cracked-machine/TremoloPedals/README.md

# TremoloPedals

[Atomizer Tremolo](Atomizer/atomizer.md)
