cracked-machine/TremoloPedals/docs/README.md

# TremoloPedals

### Atomizer Tremolo Pedal

Digitally-controlled, analog optical tremolo pedal.

| Features | Power Requirements | Audio clip |
|---|---|:---:|
|<ul><li>Adjustable mix and output gain</li><li>Lowest clock speed 2Hz</li><li>Square and Triangle waveform</li><li>Normal, Skew and Sweep modes</li><li>True bypass</li></ul>|<ul><li>9VDC</li><li>center negative</li><li>30mA</li></ul>|Watch the demo (https://www.instagram.com/p/BsmGDgeASrn/)|

<a href="atomizer_ibom.html">Interactive BOM</a>
