cracked-machine/TremoloPedals/Atomizer/atomizer.md

### Atomizer Tremolo Pedal

Digitally-controlled, analog optical tremolo pedal.

| Features | Power Requirements | Audio clip |
|---|---|:---:|
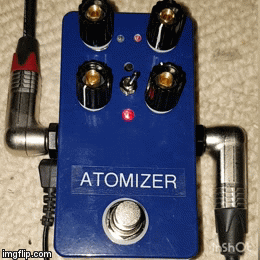
[picture p1: Atomizer/docs/Atomizer.gif]
Watch the demo (https://www.instagram.com/p/BsmGDgeASrn/)
|<ul><li>Adjustable mix and output gain</li><li>Lowest clock speed 2Hz</li><li>Square and Triangle waveform</li><li>Normal, Skew and Sweep modes</li><li>True bypass</li></ul>|<ul><li>9VDC</li><li>center negative</li><li>30mA</li></ul>||

<a href="https://cracked-machine.github.io/TremoloPedals/Atomizer/docs/IBOM/ibom.html">Interactive BOM</a>
