cracked-machine/TremoloPedals/Atomizer/docs/AtomizerRevA_BoardBottomCopper.png

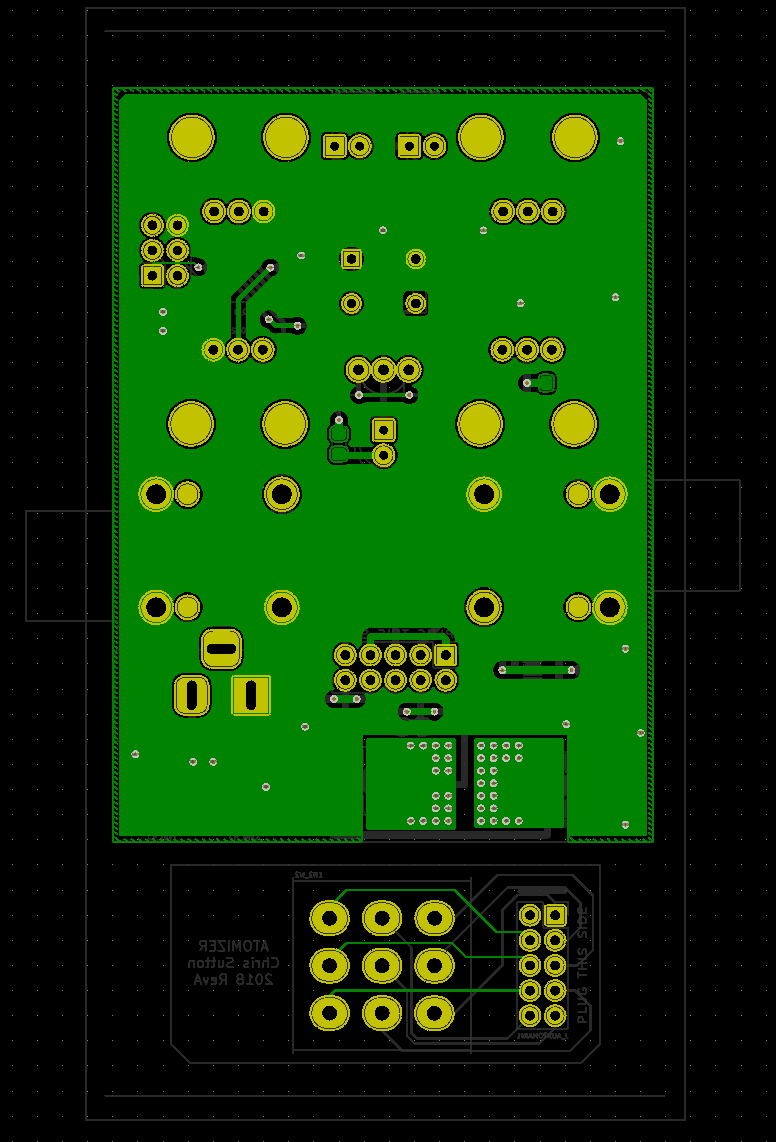
Atomizer/docs/AtomizerRevA_BoardBottomCopper.png
