cracked-machine/TremoloPedals/Atomizer/docs/AtomizerRevA_BoardTopCopper.png

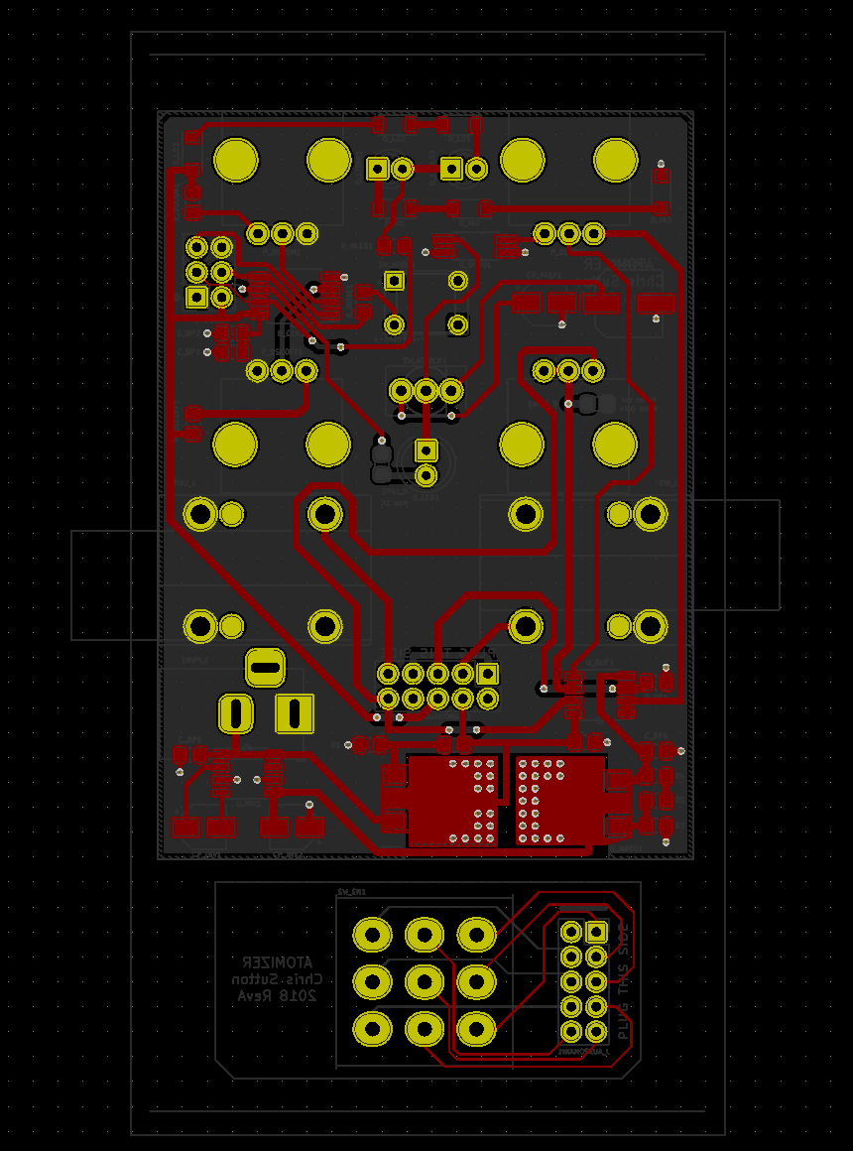
Atomizer/docs/AtomizerRevA_BoardTopCopper.png
