cracked-machine/TremoloPedals/Atomizer/docs/BoardLayout_3DRenderings/Populated.png

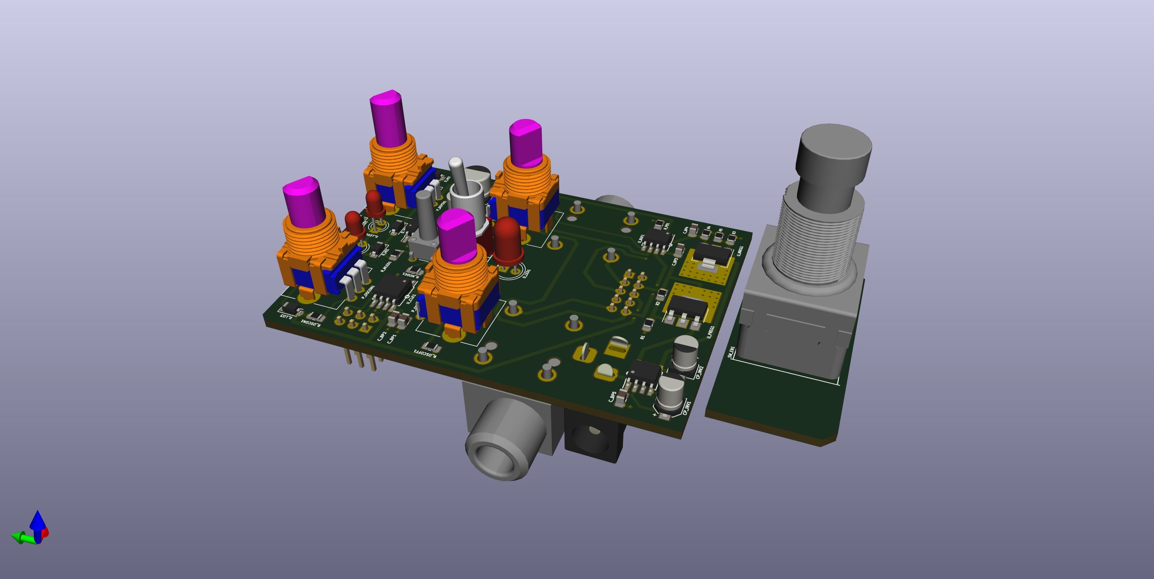
Atomizer/docs/BoardLayout_3DRenderings/Populated.png
