cracked-machine/TremoloPedals/Atomizer/docs/BoardLayout_3DRenderings/Unpopulated.png

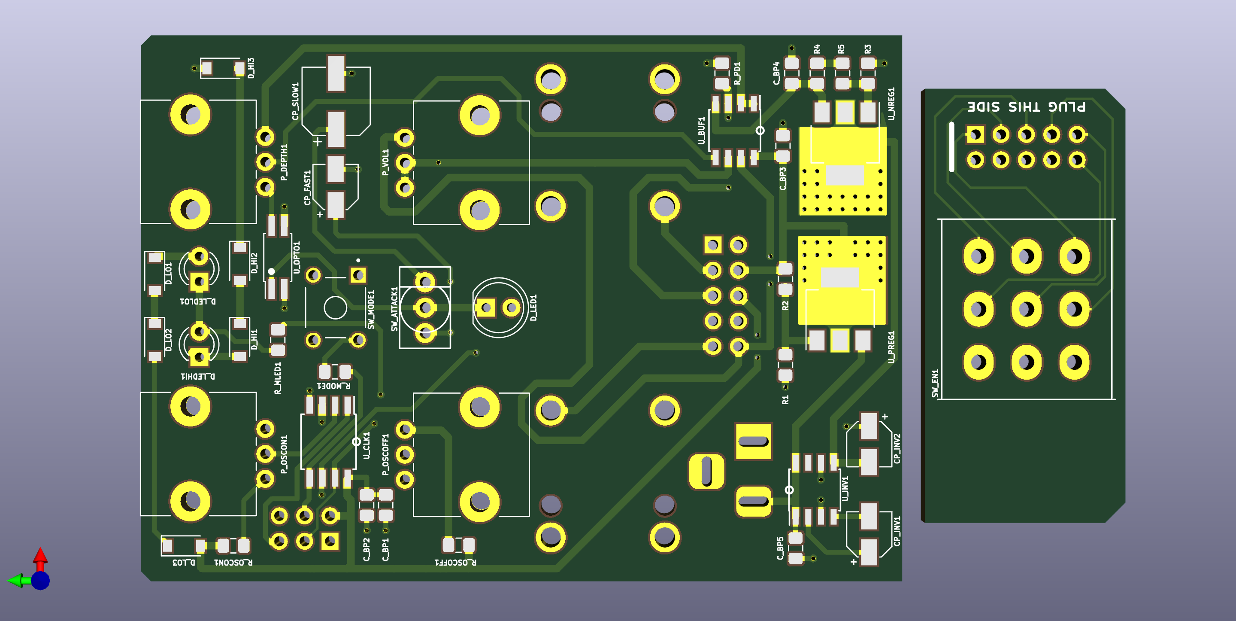
Atomizer/docs/BoardLayout_3DRenderings/Unpopulated.png
