cracked-machine/TremoloPedals/Atomizer/docs/Bypass/bp_47u.png

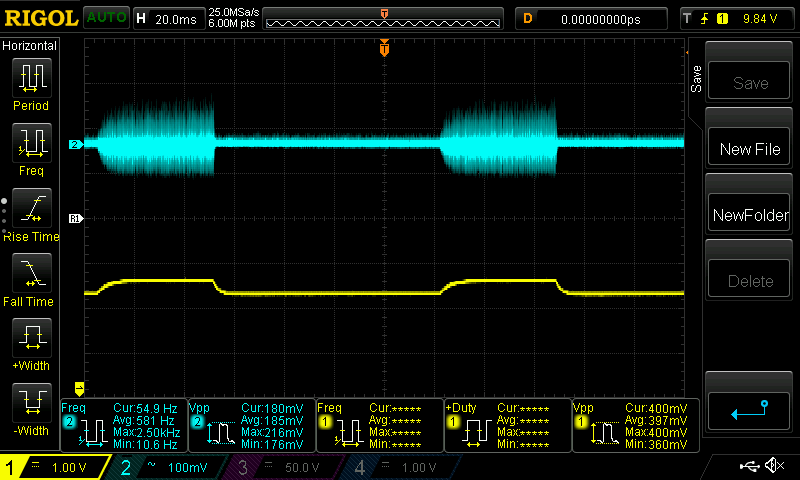
Atomizer/docs/Bypass/bp_47u.png
