cracked-machine/TremoloPedals/Atomizer/docs/Bypass/bp_100n.png

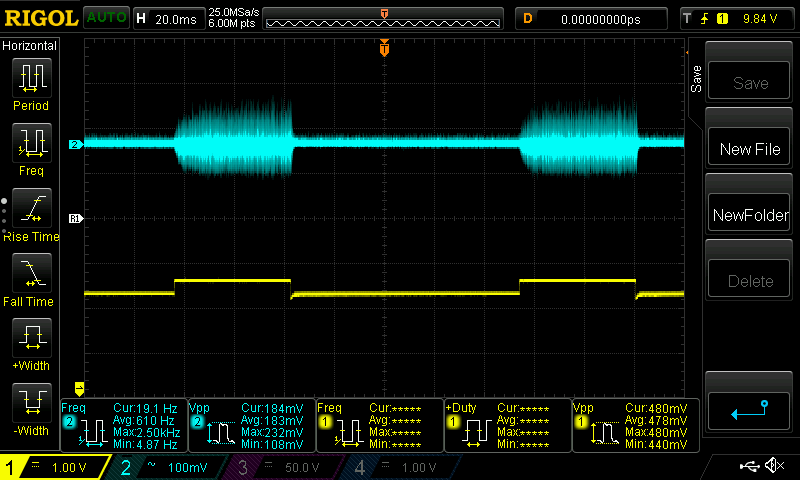
Atomizer/docs/Bypass/bp_100n.png
