cracked-machine/TremoloPedals/HexTremolo/docs/3D1.png

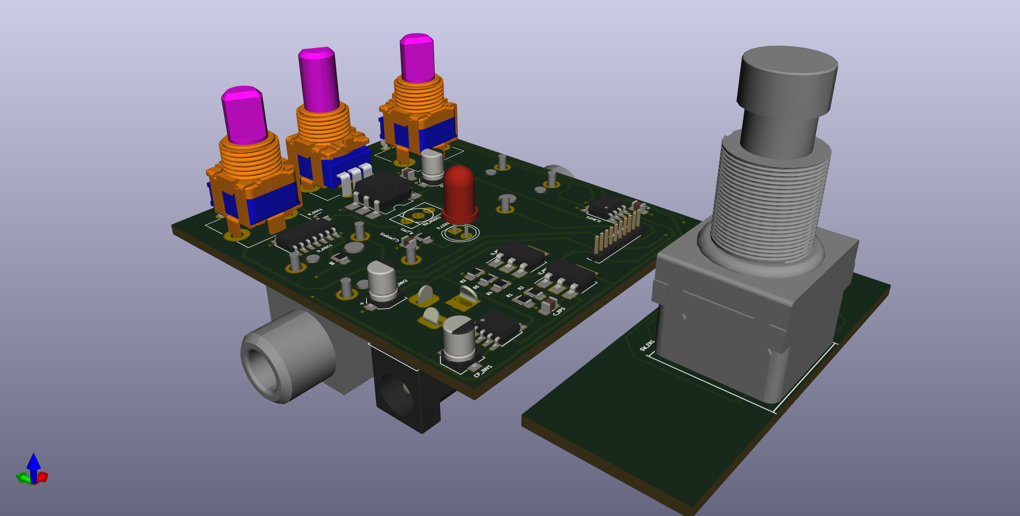
HexTremolo/docs/3D1.png
