cracked-machine/TremoloPedals/HexTremolo/docs/3D2.png

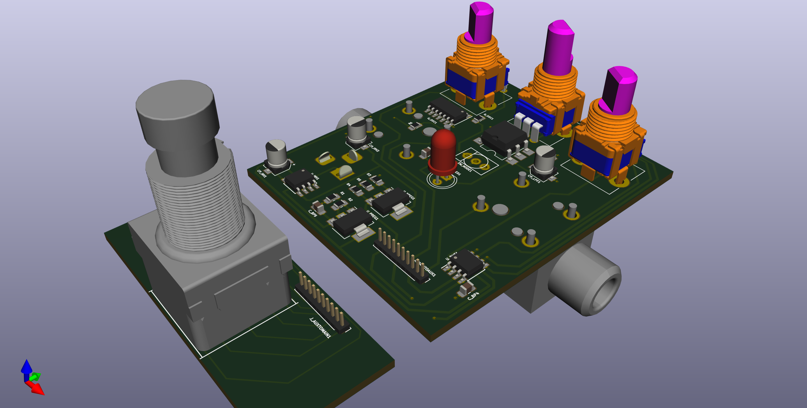
HexTremolo/docs/3D2.png
