cracked-machine/TremoloPedals/HexTremolo/docs/3D3.png

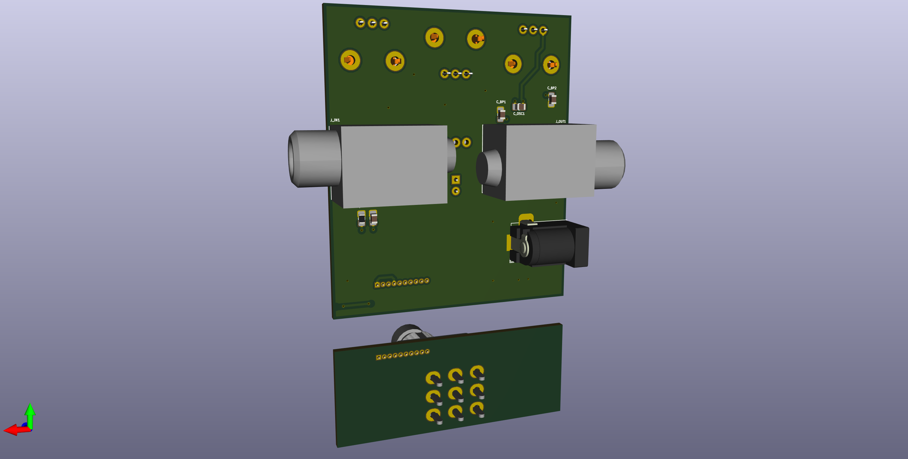
HexTremolo/docs/3D3.png
