cracked-machine/TremoloPedals/Atomizer/docs/SchematicFIles/Atomizer.pdf

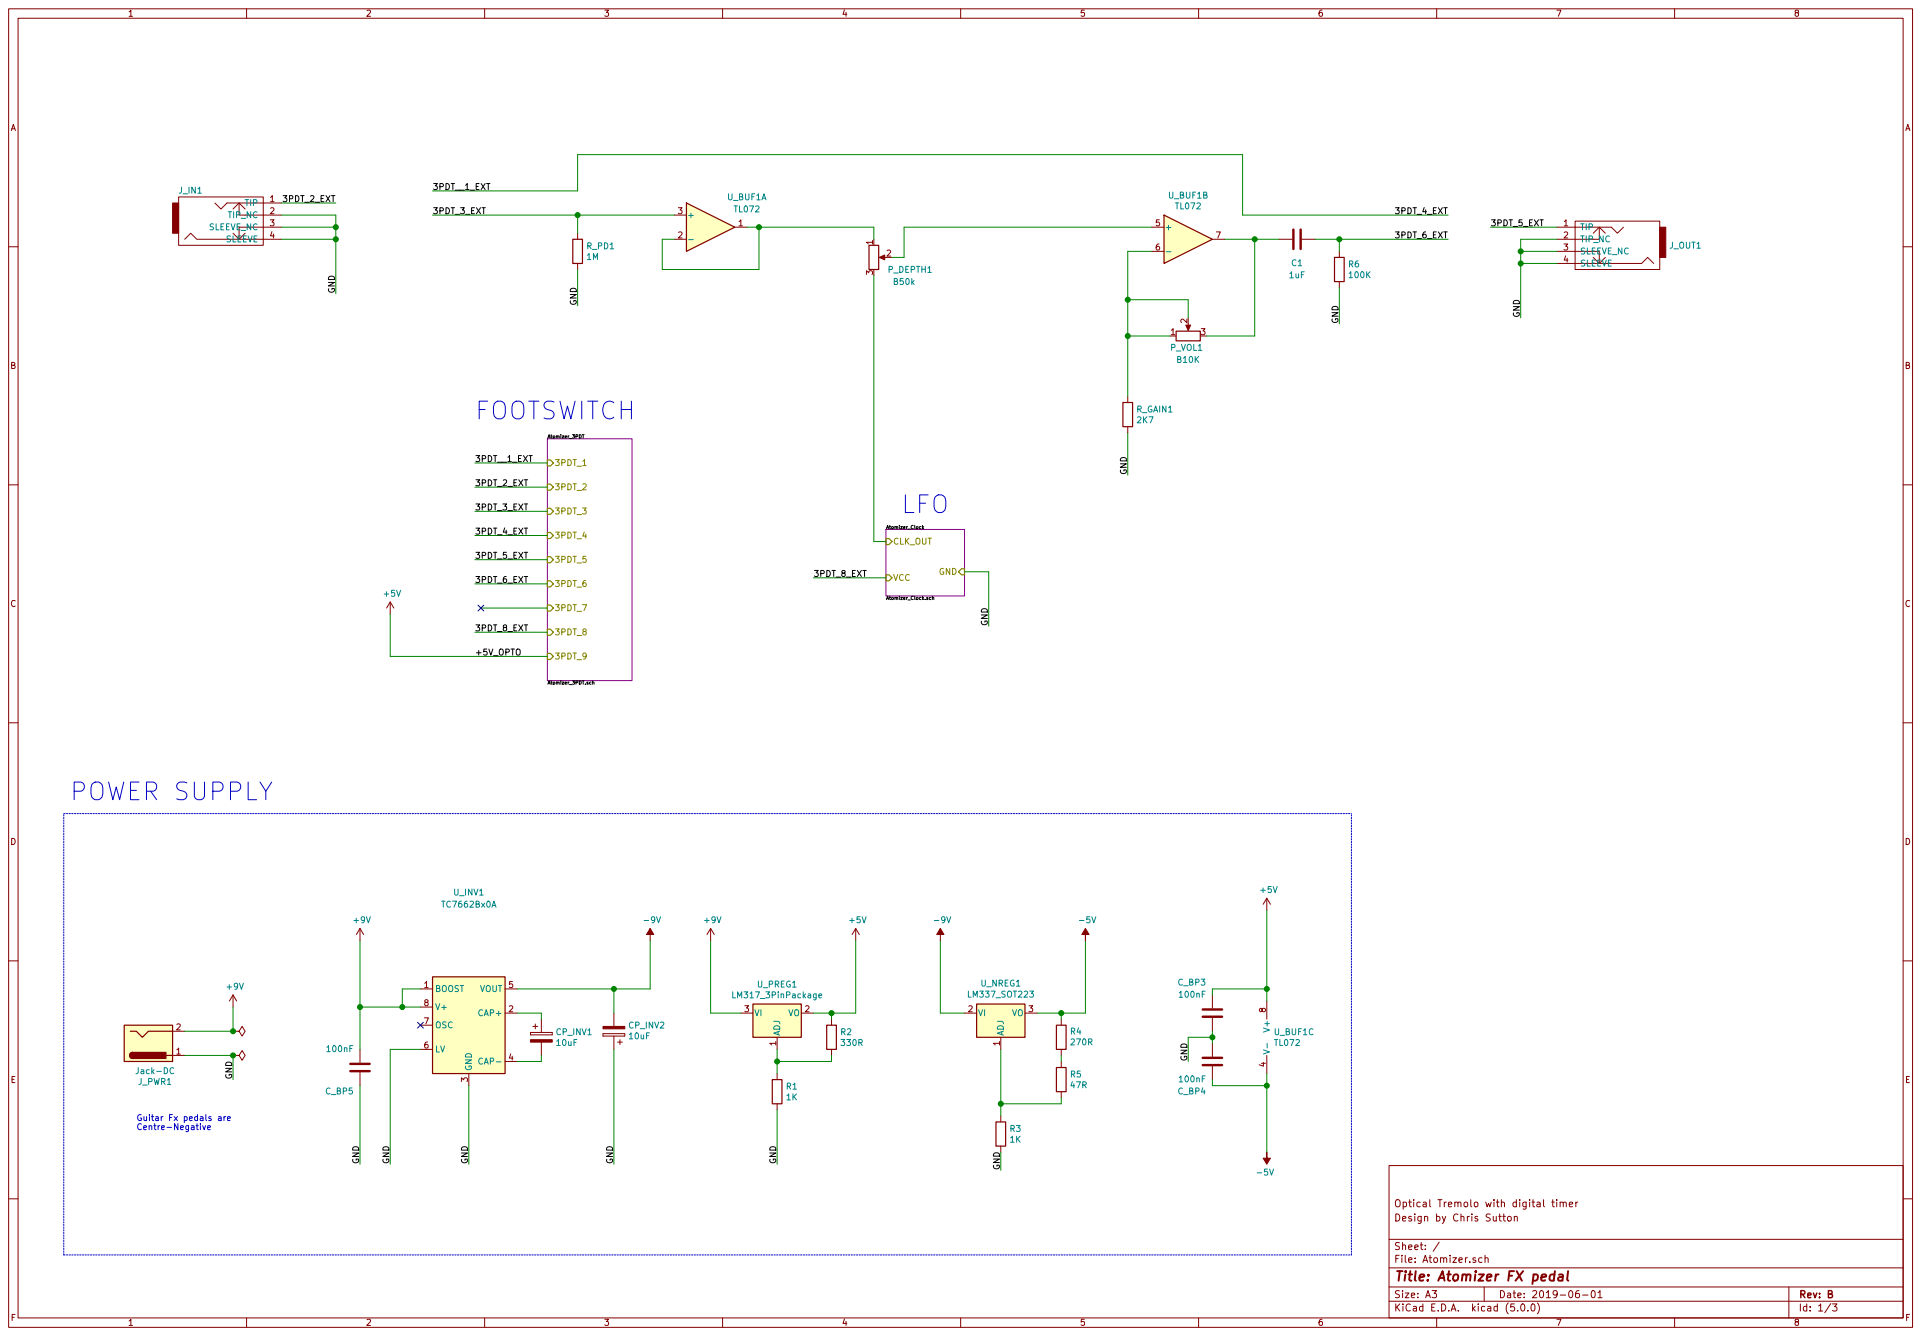
[picture p13: page 1]

Guitar Fx pedals are
Centre-Negative

Id: 1/3 Title: Atomizer FX pedal File: Atomizer.sch Sheet: / Design by Chris Sutton

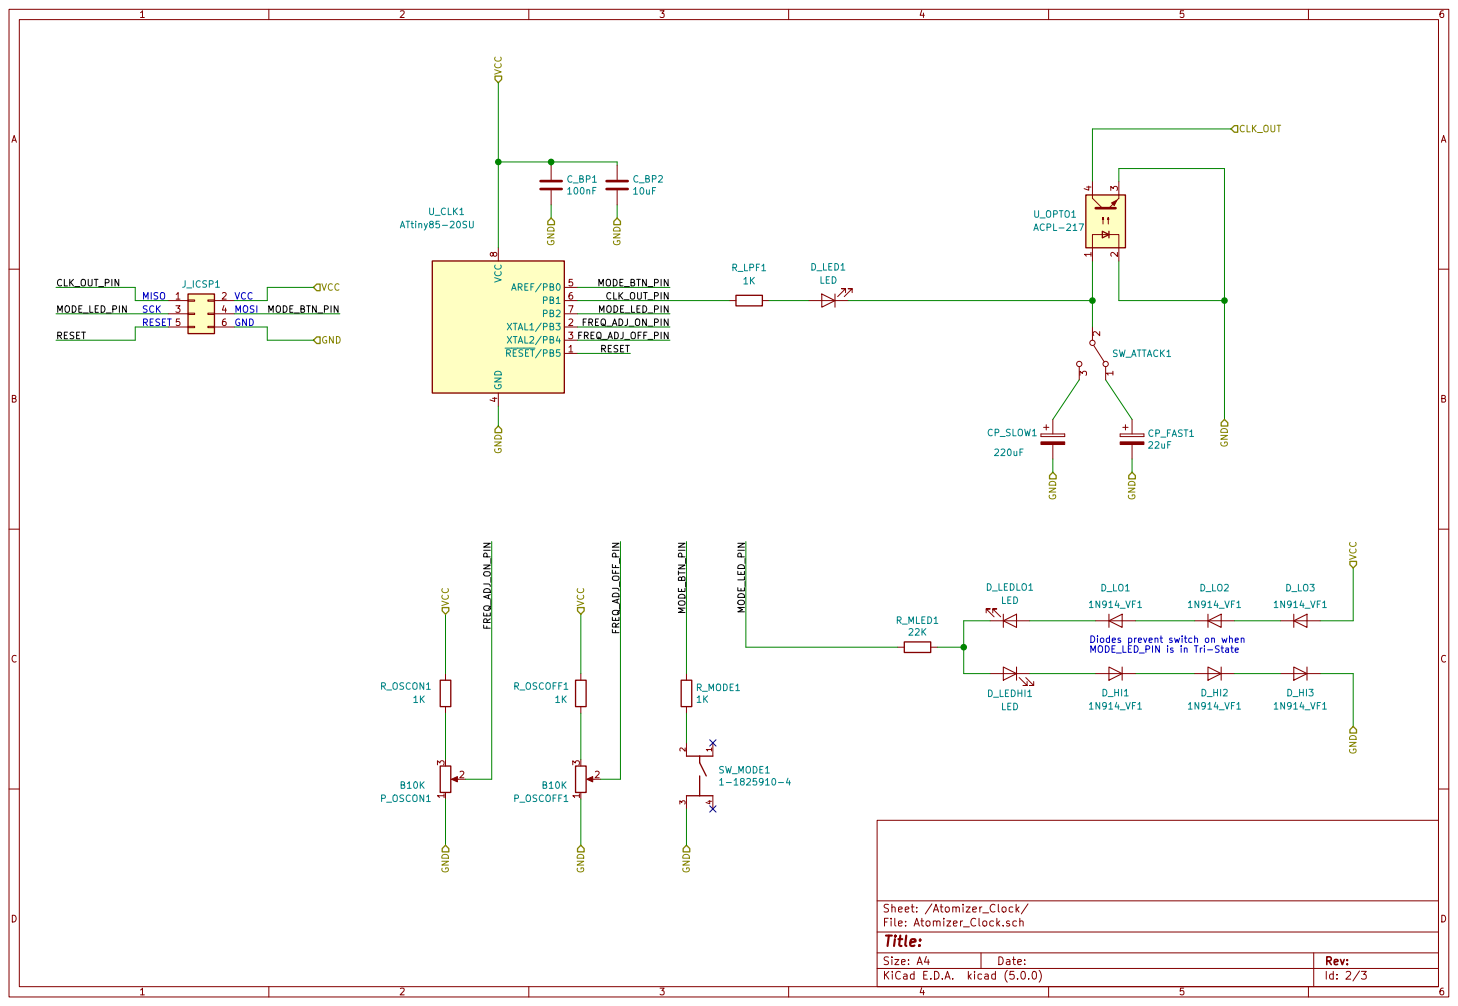
[picture p14: page 2]

Diodes prevent switch on when MODE_LED_PIN is in Tri-State D_LO2

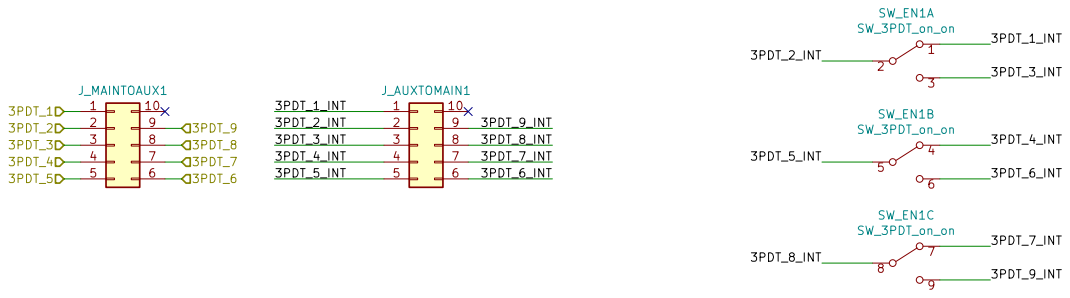
[picture p15: page 3]
