cracked-machine/TremoloPedals/HexTremolo/docs/HexTremolo.pdf

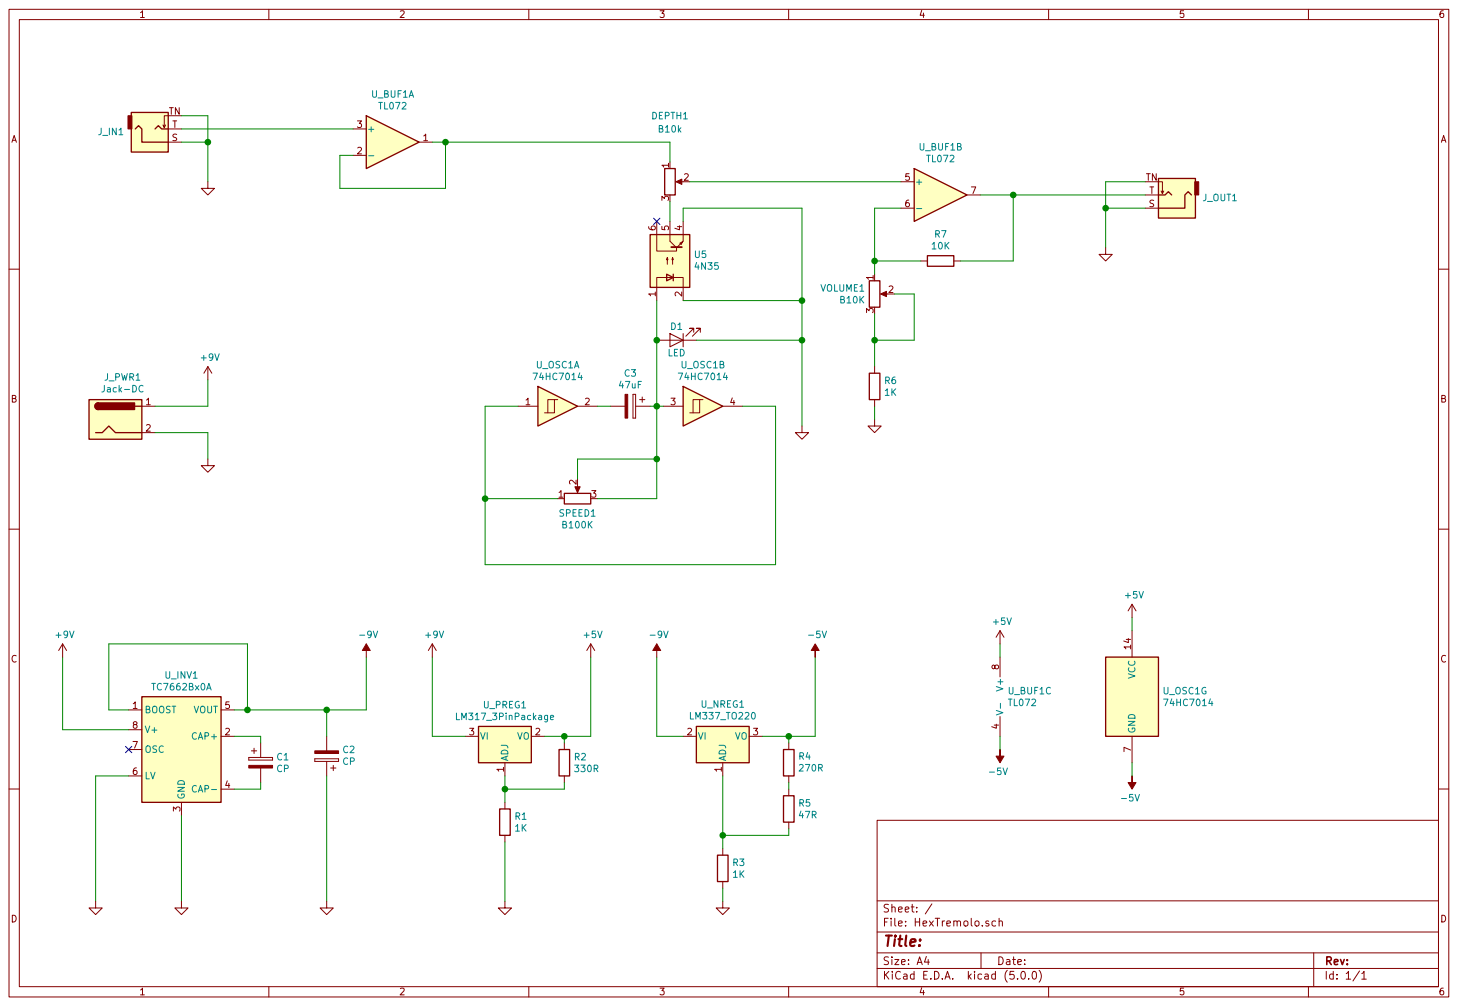
[picture p16: page 1]
