cracked-machine/TremoloPedals/Atomizer/hardware/Atomizer.kicad_pcb

## KiCad design Atomizer/hardware/Atomizer.kicad_pcb (2019-06-01)

Schematic: Atomizer.sch, Atomizer FX pedal

Parts:
C1: 1uF; C_0805_2012Metric_Pad1.15x1.40mm_HandSolder
CP_INV1, CP_INV2: 10uF; CP_Elec_4x5.4; MouserNo 140-VE100M1CTR0405
C_BP3, C_BP4, C_BP5: 100nF; C_0805_2012Metric_Pad1.15x1.40mm_HandSolder; MouserNo 710-885012207098
J_IN1: JACK__MONO_2P_NC; 6_35MM_JACK_MONO_FlatTop_notab; MouserNo 550-10284G
J_OUT1: JACK__MONO_2P_NC; 6_35MM_JACK_MONO_FlatTop_notab; MouserNo 550-10284G
J_PWR1: Jack-DC; BarrelJack_Horizontal; MouserNo 502-RAPC722X
P_DEPTH1: B50k; Potentiometer_Alps_RK09L_Single_Vertical; MouserNo 688-RK09L1140A5P
P_VOL1: B10K; Potentiometer_Alps_RK09L_Single_Vertical; MouserNo 688-RK09L1140A66
R1, R3: 1K; R_0805_2012Metric_Pad1.15x1.40mm_HandSolder; MouserNo 279-CRGP0805F1K0
R2: 330R; R_0805_2012Metric_Pad1.15x1.40mm_HandSolder; MouserNo 71-CRCW0805330RFKEAC
R4: 270R; R_0805_2012Metric_Pad1.15x1.40mm_HandSolder; MouserNo 667-ERJ-6ENF2700V
R5: 47R; R_0805_2012Metric_Pad1.15x1.40mm_HandSolder; MouserNo 667-ERJ-6ENF47R0V
R6: 100K; R_0805_2012Metric_Pad1.15x1.40mm_HandSolder
R_GAIN1: 2K7; R_0805_2012Metric_Pad1.15x1.40mm_HandSolder; MouserNo 279-CRGCQ0805F2K7
R_PD1: 1M; R_0805_2012Metric_Pad1.15x1.40mm_HandSolder; MouserNo 755-UCR10EVHFSR022
U_BUF1: TL072; SOIC-8_3.9x4.9mm_P1.27mm; MouserNo 621-TL072SG-13
U_INV1: TC7662Bx0A; SOIC-8_3.9x4.9mm_P1.27mm; MouserNo 579-TC7660SEOA713
U_NREG1: LM337_SOT223; SOT-223-3_TabPin2; MouserNo 926-LM337IMP/NOPB
U_PREG1: LM317_3PinPackage; SOT-223-3_TabPin2; MouserNo 595-LM317DCYR

Connections:
+5V: C_BP3.2, R2.1, U_BUF1.8 (V+), U_PREG1.2; also elsewhere on the board
+9V: C_BP5.2, J_PWR1.2, U_INV1.1, U_INV1.8, U_PREG1.3
-5V: C_BP4.1, R4.2, U_BUF1.4 (V-), U_NREG1.3
-9V: CP_INV2.2, U_INV1.5, U_NREG1.2
/3PDT_2_EXT: J_IN1.1; also elsewhere on the board
/3PDT_3_EXT: R_PD1.1, U_BUF1.3 (+); also elsewhere on the board
/3PDT_5_EXT: J_OUT1.1; also elsewhere on the board
/3PDT_6_EXT: C1.1, R6.1; also elsewhere on the board
/Atomizer_Clock/CLK_OUT: P_DEPTH1.3; also elsewhere on the board
/GND: CP_INV2.1, C_BP3.1, C_BP4.2, C_BP5.1, J_IN1.2, J_IN1.3, J_IN1.4, J_OUT1.2, J_OUT1.3, J_OUT1.4, J_PWR1.1, R1.2, R3.2, R6.2, R_GAIN1.2, R_PD1.2, U_INV1.3, U_INV1.6; also elsewhere on the board
unnamed: C1.2, P_VOL1.3, U_BUF1.7
unnamed: CP_INV1.1, U_INV1.2
unnamed: CP_INV1.2, U_INV1.4
unnamed: P_DEPTH1.1, U_BUF1.1, U_BUF1.2 (-)
unnamed: P_DEPTH1.2, U_BUF1.5 (+)
unnamed: P_VOL1.1, P_VOL1.2, R_GAIN1.1, U_BUF1.6 (-)
unnamed: R1.1, R2.2, U_PREG1.1
unnamed: R3.1, R5.2, U_NREG1.1
unnamed: R4.1, R5.1

Notes on the sheet:
POWER SUPPLY
FOOTSWITCH
LFO
Guitar Fx pedals are Centre-Negative

Schematic: Atomizer_Clock.sch

Parts:
CP_FAST1: 22uF; CP_Elec_4x5.4; Tolerance 20%; Voltage Rating DC 10 DC; MouserNo 710-875105240003
CP_SLOW1: 220uF; CP_Elec_6.3x5.4; Voltage Rating DC 16 VDC; Tolerance 20 %; MouserNo 667-EEE-FPC221XAP
C_BP1: 100nF; C_0805_2012Metric_Pad1.15x1.40mm_HandSolder; MouserNo 710-885012207098
C_BP2: 10uF; C_0805_2012Metric_Pad1.15x1.40mm_HandSolder; MouserNo 81-GRM21BC81C106KE5K
D_HI1, D_HI2, D_HI3: 1N914_VF1; D_SOD-123; MouserNo 821-1N914BWRH
D_LED1: LED; LED_D5.0mm; MouserNo 859-LTL-307EE
D_LEDHI1: LED; LED_D3.0mm; MouserNo 941-C4SMABGFCR2T3451
D_LEDLO1: LED; LED_D3.0mm; MouserNo 941-C4SMABGFCR2T3451
D_LO1, D_LO2, D_LO3: 1N914_VF1; D_SOD-123; MouserNo 821-1N914BWRH
J_ICSP1: Conn_02x03_Odd_Even; PinHeader_2x03_P2.54mm_Vertical; MouserNo 538-22-28-4062
P_OSCOFF1: B10K; Potentiometer_Alps_RK09L_Single_Vertical; MouserNo 688-RK09L1140A66
P_OSCON1: B10K; Potentiometer_Alps_RK09L_Single_Vertical; MouserNo 688-RK09L1140A66
R_LPF1: 1K; R_0805_2012Metric_Pad1.15x1.40mm_HandSolder; MouserNo 279-CRGP0805F1K0
R_MLED1: 22K; R_0805_2012Metric_Pad1.15x1.40mm_HandSolder; MouserNo 667-ERJ-6ENF2202V
R_MODE1: 1K; R_0805_2012Metric_Pad1.15x1.40mm_HandSolder; MouserNo 279-CRGP0805F1K0
R_OSCOFF1: 1K; R_0805_2012Metric_Pad1.15x1.40mm_HandSolder; MouserNo 279-CRGP0805F1K0
R_OSCON1: 1K; R_0805_2012Metric_Pad1.15x1.40mm_HandSolder; MouserNo 279-CRGP0805F1K0
SW_ATTACK1: SW_SPDT; Dailywell_SPDT; MouserNo 108-2MS1T1B1M2QE-EVX
SW_MODE1: 1-1825910-4; SW_2-1825910-7; MouserNo 506-1-1825910-4
U_CLK1: ATtiny85-20SU; SOIJ-8_5.3x5.3mm_P1.27mm; MouserNo 556-ATTINY85-20SU
U_OPTO1: ACPL-217; SO-4_4.4x2.3mm_P1.27mm; MouserNo 630-ACPL-217-50BE

Connections:
/3PDT_8_EXT: C_BP1.1, C_BP2.1, D_LO3.2, J_ICSP1.2, R_OSCOFF1.2, R_OSCON1.2, U_CLK1.8 (VCC); also elsewhere on the board
/Atomizer_Clock/CLK_OUT: U_OPTO1.4; also elsewhere on the board
/Atomizer_Clock/CLK_OUT_PIN: J_ICSP1.1, R_LPF1.2, U_CLK1.6 (PB1)
/Atomizer_Clock/FREQ_ADJ_OFF_PIN: P_OSCOFF1.2, U_CLK1.3 (XTAL2/PB4)
/Atomizer_Clock/FREQ_ADJ_ON_PIN: P_OSCON1.2, U_CLK1.2 (XTAL1/PB3)
/Atomizer_Clock/MODE_BTN_PIN: J_ICSP1.4, R_MODE1.1, U_CLK1.5 (AREF/PB0)
/Atomizer_Clock/MODE_LED_PIN: J_ICSP1.3, R_MLED1.2, U_CLK1.7 (PB2)
/Atomizer_Clock/RESET: J_ICSP1.5, U_CLK1.1 (~RESET~/PB5)
/GND: CP_FAST1.2, CP_SLOW1.2, C_BP1.2, C_BP2.2, D_HI3.1, J_ICSP1.6, P_OSCOFF1.1, P_OSCON1.1, SW_MODE1.3, U_CLK1.4 (GND), U_OPTO1.2, U_OPTO1.3; also elsewhere on the board
unnamed: CP_FAST1.1, SW_ATTACK1.1
unnamed: CP_SLOW1.1, SW_ATTACK1.3
unnamed: D_HI1.1, D_HI2.2
unnamed: D_HI1.2, D_LEDHI1.1
unnamed: D_HI2.1, D_HI3.2
unnamed: D_LED1.1, SW_ATTACK1.2, U_OPTO1.1
unnamed: D_LED1.2, R_LPF1.1
unnamed: D_LEDHI1.2, D_LEDLO1.1, R_MLED1.1
unnamed: D_LEDLO1.2, D_LO1.1
unnamed: D_LO1.2, D_LO2.1
unnamed: D_LO2.2, D_LO3.1
unnamed: P_OSCOFF1.3, R_OSCOFF1.1
unnamed: P_OSCON1.3, R_OSCON1.1
unnamed: R_MODE1.2, SW_MODE1.2

Notes on the sheet:
Diodes prevent switch on when MODE_LED_PIN is in Tri-State
MOSI
VCC
GND
SCK
MISO
RESET

Schematic: Atomizer_3PDT.sch

Parts:
J_AUXTOMAIN1: Conn_02x05_Counter_Clockwise; IDCHeader_02x05_P2.54mm_Vertical_Counter_Clockwise; MouserNo 538-22-28-4102
J_MAINTOAUX1: Conn_02x05_Counter_Clockwise; IDCHeader_02x05_P2.54mm_Vertical_Clockwise; MouserNo 538-22-28-4102
SW_EN1: SW_3PDT_on_on; SW_3PDT_W18MM_L17.3MM_P5.3MM_D2MM; MouserNo 612-FS573PLT2B2M2QE

Connections:
+5V: J_MAINTOAUX1.9; also elsewhere on the board
/3PDT_2_EXT: J_MAINTOAUX1.2; also elsewhere on the board
/3PDT_3_EXT: J_MAINTOAUX1.3; also elsewhere on the board
/3PDT_4_EXT: J_MAINTOAUX1.1, J_MAINTOAUX1.4
/3PDT_5_EXT: J_MAINTOAUX1.5; also elsewhere on the board
/3PDT_6_EXT: J_MAINTOAUX1.6; also elsewhere on the board
/3PDT_8_EXT: J_MAINTOAUX1.8; also elsewhere on the board
/Atomizer_3PDT/3PDT_1_INT: J_AUXTOMAIN1.1, SW_EN1.1
/Atomizer_3PDT/3PDT_2_INT: J_AUXTOMAIN1.2, SW_EN1.2
/Atomizer_3PDT/3PDT_3_INT: J_AUXTOMAIN1.3, SW_EN1.3
/Atomizer_3PDT/3PDT_4_INT: J_AUXTOMAIN1.4, SW_EN1.4
/Atomizer_3PDT/3PDT_5_INT: J_AUXTOMAIN1.5, SW_EN1.5
/Atomizer_3PDT/3PDT_6_INT: J_AUXTOMAIN1.6, SW_EN1.6
/Atomizer_3PDT/3PDT_7_INT: J_AUXTOMAIN1.7, SW_EN1.7
/Atomizer_3PDT/3PDT_8_INT: J_AUXTOMAIN1.8, SW_EN1.8
/Atomizer_3PDT/3PDT_9_INT: J_AUXTOMAIN1.9, SW_EN1.9

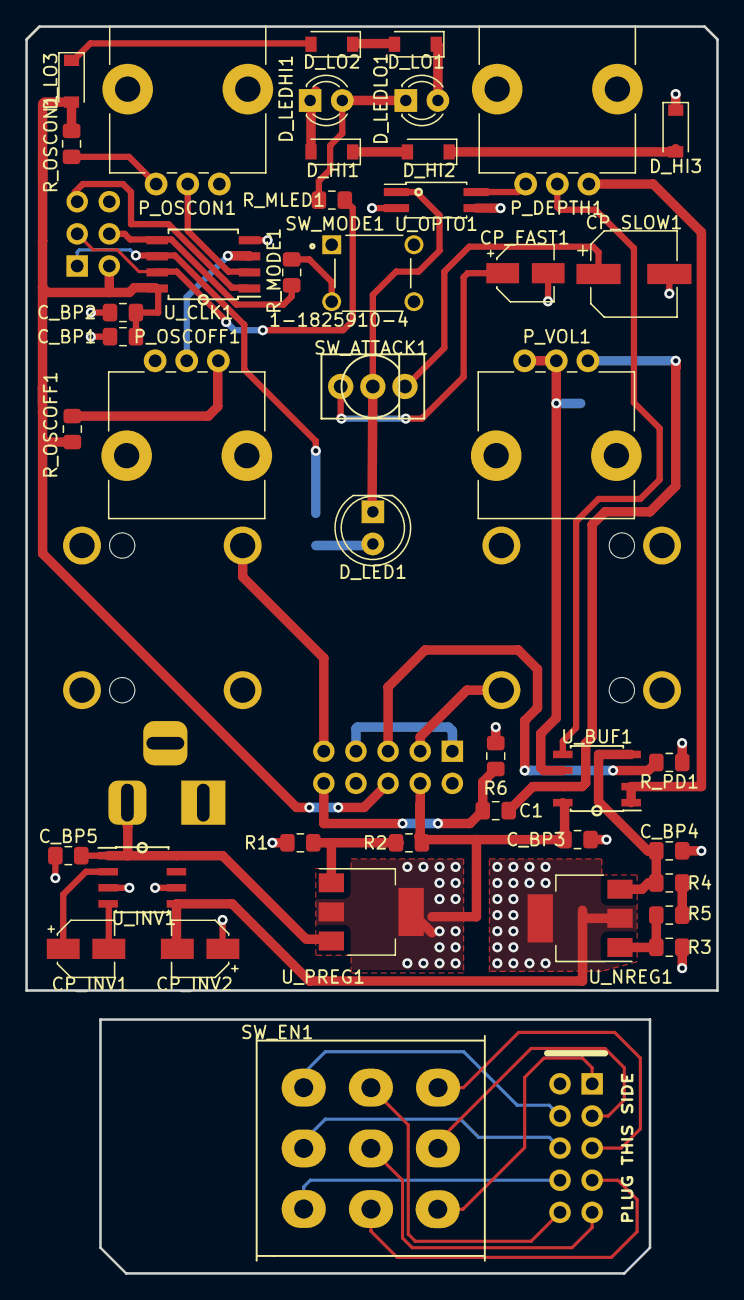
[picture p17: board Atomizer.kicad_pcb from above]

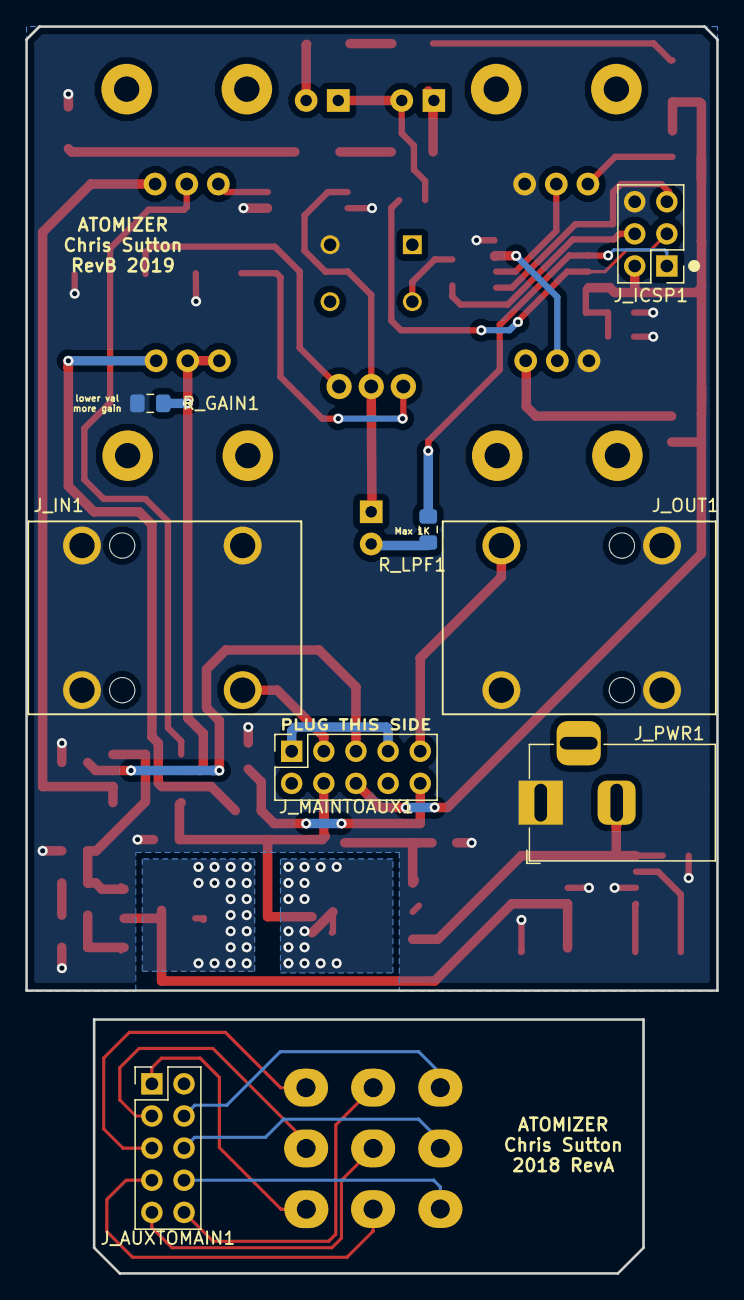
[picture p18: board Atomizer.kicad_pcb from below]

Board: 2 copper layers, 54.6 x 98.6 mm, 51 parts (8 on the bottom side), 50 nets.
