cracked-machine/TremoloPedals/EATremolo/EATremolo.kicad_pcb

## KiCad design EATremolo/EATremolo.kicad_pcb (2018-01-09)

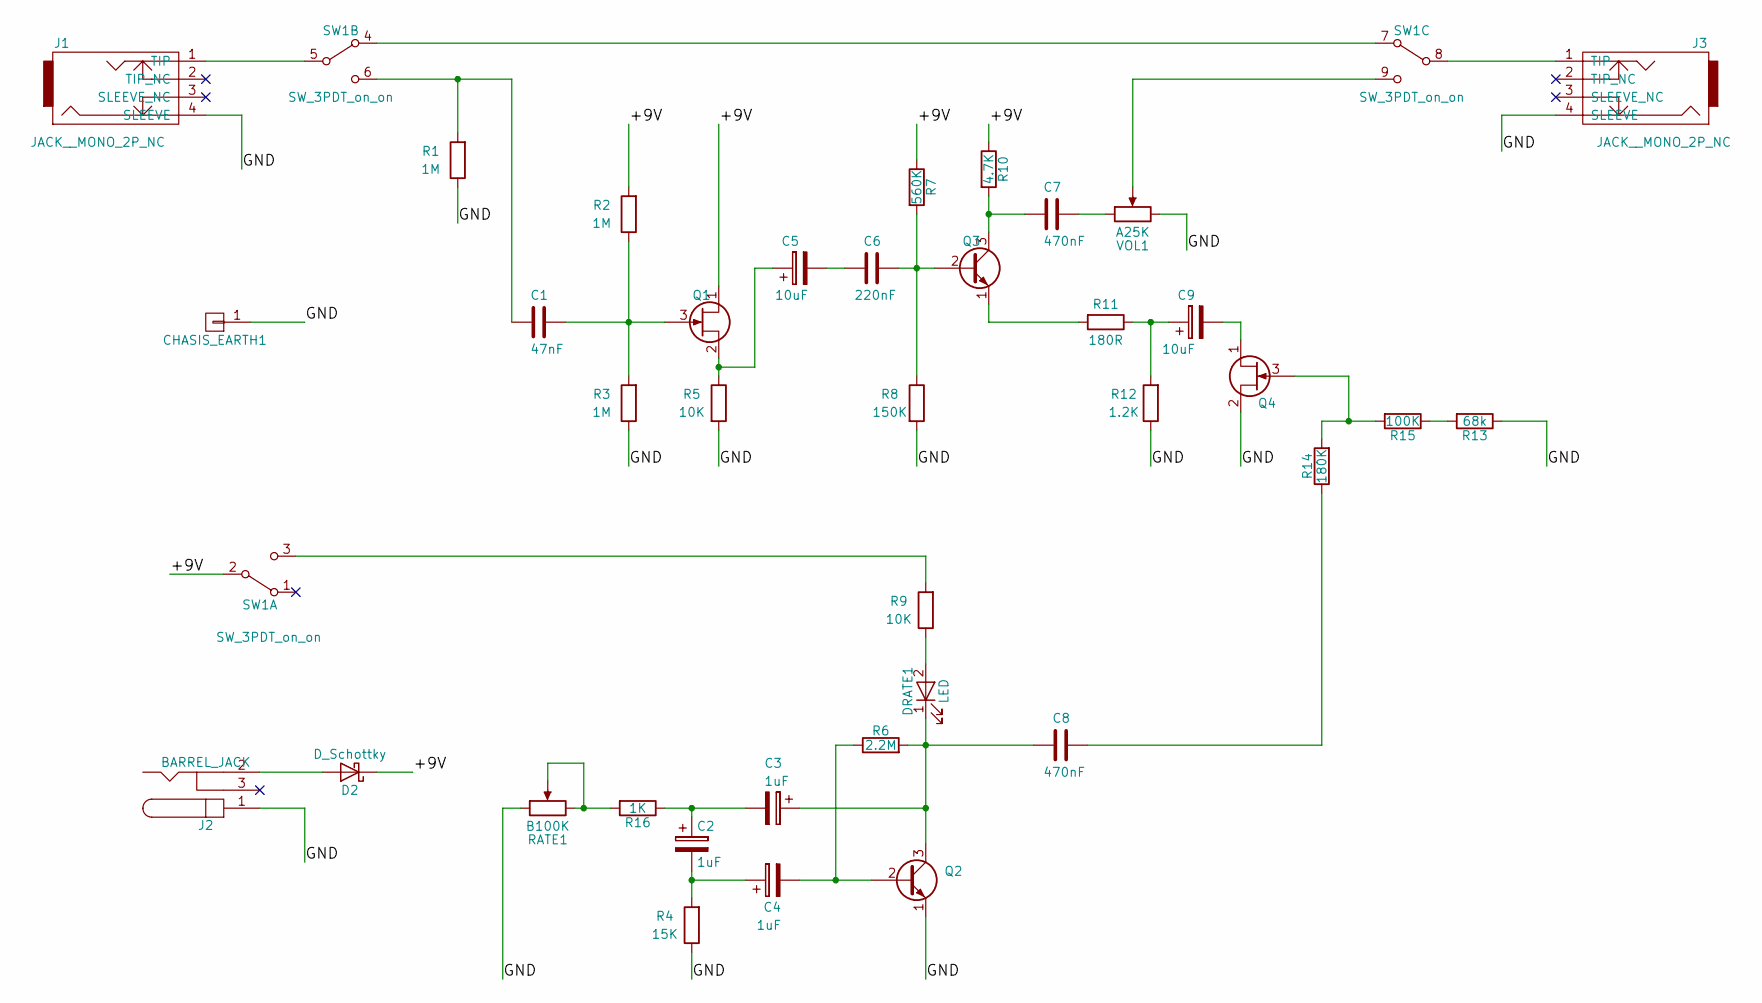
[picture p19: schematic EATremolo.sch]

Parts:
C1: 47nF; C_Disc_2mmPads
C2, C3, C4: 1uF; C_Disc_2mmPads
C5: 10uF; C_Disc_P5.0mm_2mmPads
C6: 220nF; C_Disc_2mmPads
C7: 470nF; C_Disc_P5.0mm_2mmPads
C8: 470nF; C_Disc_2mmPads
C9: 10uF; CP_Radial_D4_P2_PadSize2_Drill1
CHASIS_EARTH1: CONN_01X01; SolderWirePad_single_1mmDrill
D2: D_Schottky; D_DO-41_SOD81_P2.54mm_Vertical_AnodeUp
DRATE1: LED; LED_D5.0mm
J1, J3: JACK__MONO_2P_NC; JackSocket_Mono_PCB
J2: BARREL_JACK
Q1, Q4: Q_NJFET_DSG; SOT-23_Handsoldering
Q2, Q3: Q_NPN_EBC; TO-92_Inline_Wide
R1, R2, R3: 1M; R_Axial_DIN0207_Vertical_2mmPad
R4: 15K; R_Axial_DIN0207_Vertical_2mmPad
R5: 10K; R_Axial_DIN0207_P5.08mm_2mmPads
R6: 2.2M; R_Axial_DIN0207_Vertical_2mmPad
R7: 560K; R_Axial_DIN0207_Vertical_2mmPad
R8: 150K; R_Axial_DIN0207_Vertical_2mmPad
R9: 10K; R_Axial_DIN0207_Vertical_2mmPad
R10: 4.7K; R_Axial_DIN0207_Vertical_2mmPad
R11: 180R; R_Axial_DIN0207_P5.08mm_2mmPads
R12: 1.2K; R_Axial_DIN0207_Vertical_2mmPad
R13: 68k; R_Axial_DIN0207_Vertical_2mmPad
R14: 180K; R_Axial_DIN0207_Vertical_2mmPad
R15: 100K; R_Axial_DIN0207_Vertical_2mmPad
R16: 1K; R_Axial_DIN0207_Vertical_2mmPad
RATE1: B100K; Potentiometer_Omeg_PC16PU_Horizontal
SW1: SW_3PDT_on_on; SW_3PDT_W18MM_L17.3MM_P5.3MM_D2MM
VOL1: A25K; Potentiometer_Omeg_PC16PU_Horizontal

Connections:
/+9V: D2.1 (K), Q1.1 (D), R2.2, R7.1, R10.1, SW1.2 (B)
/GND: CHASIS_EARTH1.1, J1.4 (SLEEVE), J2.1, J3.4 (SLEEVE), Q2.1 (E), Q4.2 (S), R1.1, R3.1, R4.1, R5.2, R8.2, R12.1, R13.1, RATE1.1, VOL1.3
unnamed: C1.1, Q1.3 (G), R2.1, R3.2
unnamed: C1.2, R1.2, SW1.6 (C)
unnamed: C2.1, C3.2, R16.1
unnamed: C2.2, C4.1, R4.2
unnamed: C3.1, C8.2, DRATE1.1 (K), Q2.3 (C), R6.2
unnamed: C4.2, Q2.2 (B), R6.1
unnamed: C5.1, Q1.2 (S), R5.1
unnamed: C5.2, C6.2
unnamed: C6.1, Q3.2 (B), R7.2, R8.1
unnamed: C7.1, VOL1.1
unnamed: C7.2, Q3.3 (C), R10.2
unnamed: C8.1, R14.1
unnamed: C9.1, R11.1, R12.2
unnamed: C9.2, Q4.1 (D)
unnamed: D2.2 (A), J2.2
unnamed: DRATE1.2 (A), R9.1
unnamed: J1.1 (TIP), SW1.5 (B)
unnamed: J3.1 (TIP), SW1.8 (B)
unnamed: Q3.1 (E), R11.2
unnamed: Q4.3 (G), R14.2, R15.2
unnamed: R9.2, SW1.3 (C)
unnamed: R13.2, R15.1
unnamed: R16.2, RATE1.2, RATE1.3
unnamed: SW1.4 (A), SW1.7 (A)
unnamed: SW1.9 (C), VOL1.2

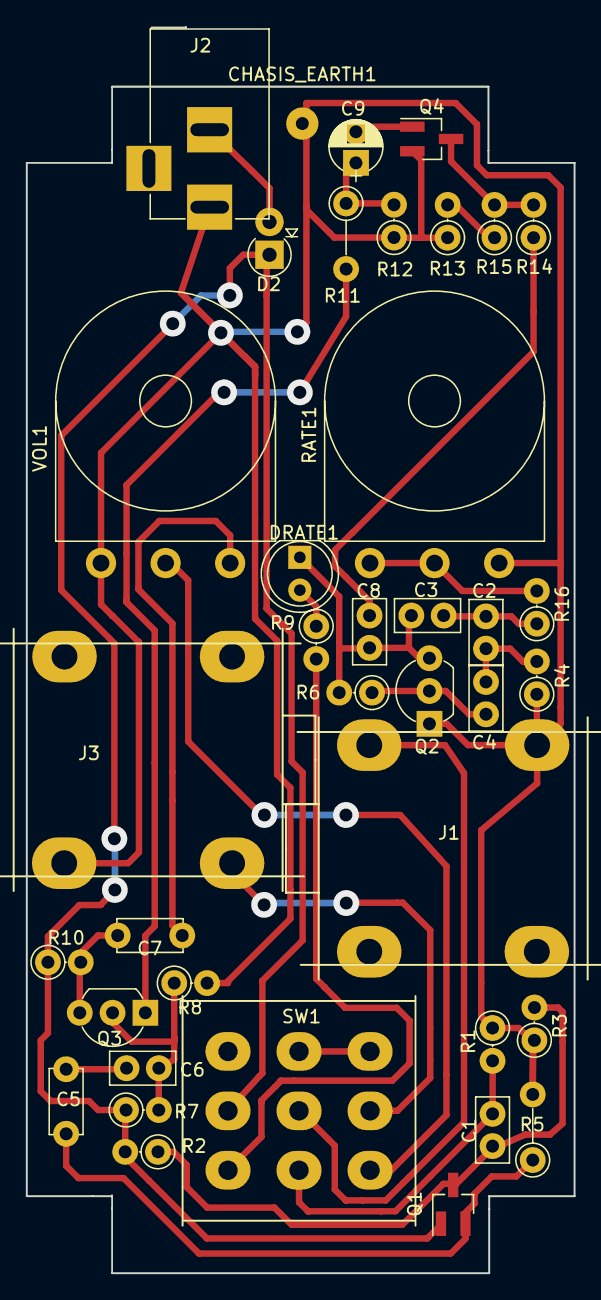
[picture p20: board EATremolo.kicad_pcb from above]

Board: 2 copper layers, 42.4 x 96.5 mm, 38 parts (0 on the bottom side), 27 nets.
