cracked-machine/TremoloPedals/JFETTremolo/V0.1/JFETTremolo.kicad_pcb

## KiCad design JFETTremolo/V0.1/JFETTremolo.kicad_pcb (2017-12-01, an earlier design)

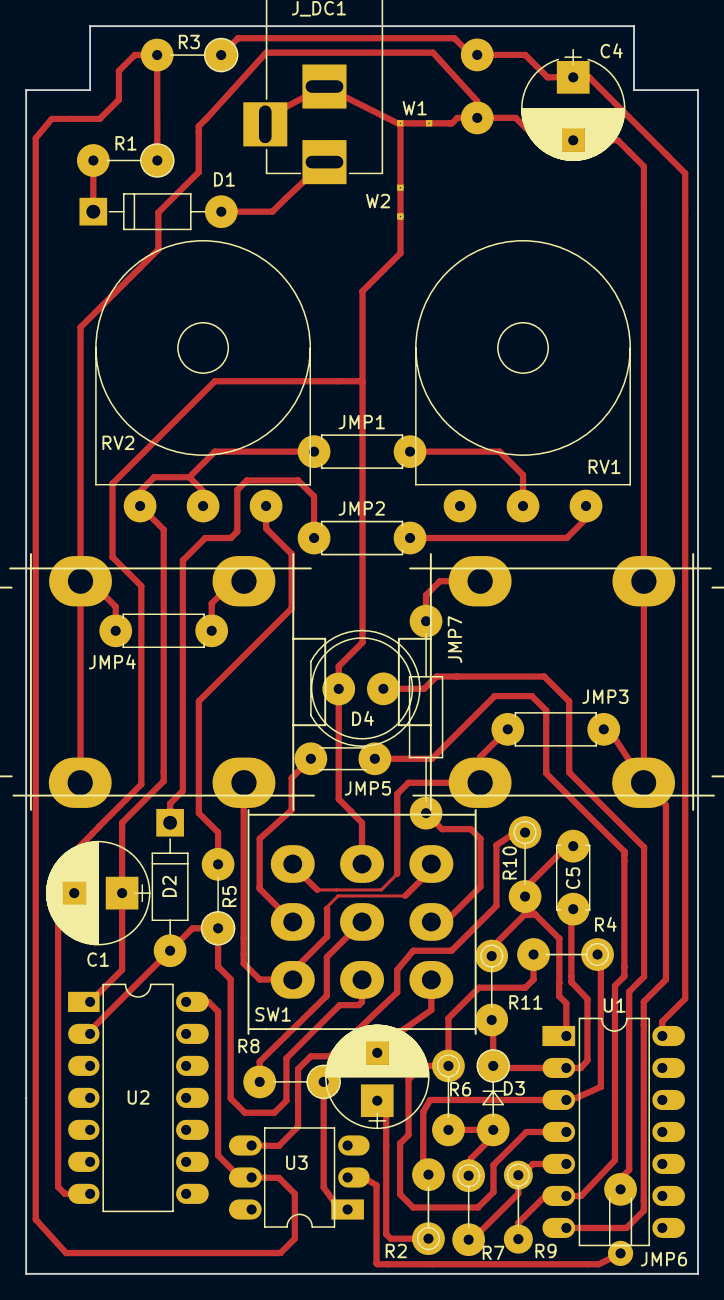
[picture p21: board JFETTremolo.kicad_pcb from above]

Board: 2 copper layers, 53.3 x 99.1 mm, 38 parts (1 on the bottom side), 31 nets.

Parts:
C1: 10U; CP_Radial_D8.0mm_P3.80mm
C2: 1u; CP_Radial_D8.0mm_P3.80mm
C3: 10n; C_Disc_D5.0mm_W2.5mm_P5.00mm
C4: 47u; CP_Radial_D8.0mm_P5.00mm
C5: 470n; C_Disc_D5.0mm_W2.5mm_P5.00mm
D1, D2: D; D_DO-41_SOD81_P10.16mm_Horizontal
D3: D; D_DO-35_SOD27_P5.08mm_Vertical_AnodeUp
D4: LED; LED_D8.0mm
JMP1, JMP2, JMP3, JMP4: 0; R_Axial_DIN0207_L6.3mm_D2.5mm_P7.62mm_Horizontal
JMP5, JMP6: 0; R_Axial_DIN0204_L3.6mm_D1.6mm_P5.08mm_Horizontal
JMP7: 0; R_Axial_DIN0207_L6.3mm_D2.5mm_P15.24mm_Horizontal
J_DC1: BARREL_JACK
J_IN1: JACK__MONO_2P_NC; JackSocket_Mono_PCB
J_OUT1: JACK__MONO_2P_NC; JackSocket_Mono_PCB
R1: 100R; R_Axial_DIN0207_L6.3mm_D2.5mm_P5.08mm_Vertical
R2, R4, R6, R7, R9, R10, R11: 100K; R_Axial_DIN0204_L3.6mm_D1.6mm_P5.08mm_Vertical
R3, R5: 10K; R_Axial_DIN0207_L6.3mm_D2.5mm_P5.08mm_Vertical
R8: 100K; R_Axial_DIN0207_L6.3mm_D2.5mm_P5.08mm_Vertical
RV1, RV2: 100K; Potentiometer_Omeg_PC16PU_Horizontal
SW1: SW_3PDT_on_on; SW_3PDT_W18MM_L17.3MM_P5.3MM_D2MM
U1: CD4069; DIP-14_W7.62mm
U2: 4584; DIP-14_W7.62mm
U3: 4N25; DIP-6_W7.62mm
W1, W2: NetTie

Connections:
/clk_gnd: C1.2, D4.1, SW1.6, U2.7, W2.2
/clk_ota: D2.2, R5.1, SW1.4, U2.2
/clk_vdd: R1.1, R3.2, U2.14, U3.5
/fxin: C2.2, SW1.1
/fxout: JMP5.1, JMP5.2, R9.2, SW1.8, U1.6
/gnd: J_DC1.2, J_DC1.3, W1.1, W2.1
/mclk: C5.1, D3.1, R11.2, U1.2
/ota_clk: R10.1, U3.4
/sig_gnd: C3.2, C4.2, JMP3.1, JMP3.2, JMP4.2, J_IN1.2, J_IN1.3, J_IN1.4, J_OUT1.3, J_OUT1.4, SW1.9, U1.7, W1.2
/sig_out: J_OUT1.1, SW1.3, SW1.7
/sig_vdd: C3.1, C4.1, R3.1, U1.14
/sigin: JMP7.2, J_IN1.1
unnamed: C1.1, JMP1.1, RV2.2, RV2.3, U2.1
unnamed: C2.1, R2.1
unnamed: C5.2, R10.2, R11.1, U1.1
unnamed: D1.1, R1.2
unnamed: D1.2, J_DC1.1
unnamed: D2.1, JMP2.1
unnamed: D3.2, R6.2, R7.1
unnamed: D4.2, JMP6.2
unnamed: JMP1.2, RV1.2
unnamed: JMP2.2, RV1.1
unnamed: JMP4.1, J_OUT1.2
unnamed: JMP6.1, U3.2
unnamed: JMP7.1, SW1.2
unnamed: R2.2, R4.1, U1.3
unnamed: R4.2, R6.1, U1.4
unnamed: R5.2, RV2.1
unnamed: R7.2, R9.1, U1.5
unnamed: R8.1, U3.1
unnamed: R8.2, SW1.5
