cracked-machine/TremoloPedals/(commit log)

2017-12-01 EATemolo BOM update
2017-12-02 EA Tremolo Layout completed
    [EATremolo.kicad_pcb, EATremolo.sch, _saved_EATremolo.sch]
2017-12-02 saved EATremolo
    [EATremolo.sch, _saved_EATremolo.sch]
2017-12-04 EA Tremolo Rev2
    [EATremolo.kicad_pcb, EATremolo.sch]
2017-12-10 Created EATremoloSMD
    [EATremoloSMD.kicad_pcb, EATremoloSMD.sch]
2017-12-12 board outline update
    [EATremoloSMD.kicad_pcb]
2017-12-12 Updated EATremoloSMD
    [EATremoloSMD.kicad_pcb, EATremoloSMD.sch]
2017-12-13 EAMTremoloSMD update
    pcb header alignment
    [EATremoloSMD.kicad_pcb]
2017-12-13 Board Description Updates
    [EATremolo.kicad_pcb, EATremoloSMD.kicad_pcb]
2018-01-20 Added 555TremoloSMD
    [555TremoloSMD.kicad_pcb, 555TremoloSMD.sch]
2018-11-06 Added HexTremolo
    [HexTremolo.kicad_pcb, HexTremolo.sch]
2018-11-07 UPDATED SCHEMATIC
    removed clk tick from audio path
    - current limiting resistors at osc vcc (1W)
    - LPF at FX-side of OPTOCOUPLER
    [HexTremolo.sch]
2018-11-09 Added 555PWMTremolo Schematic
    [555PWMTremolo.kicad_pcb, 555PWMTremolo.sch, 555PWMTremolo_3PDT.sch, 555PWMTremolo_Clock.sch, 555TremoloSMD-2018-11-05-09-36-08.sch, 555TremoloSMD.kicad_pcb, 555TremoloSMD.sch, HexInverter_3PDT.sch]
2018-11-09 Completed 555PWMTremolo Layout RevA
    [555PWMTremolo.kicad_pcb, 555PWMTremolo.sch, 555PWMTremolo_Clock.sch]
2018-11-09 Tidied up 555 layout
    [555PWMTremolo.kicad_pcb, 555PWMTremolo.sch, 555PWMTremolo_Clock.sch]
2018-11-09 Final RevA
    [555PWMTremolo.kicad_pcb, 555PWMTremolo_3PDT.sch, 555PWMTremolo_Clock.sch]
2018-11-14 Board Layout Corrections
    Aux Board Ribbon cable header inversed
    [555PWMTremolo.kicad_pcb]
2018-11-15 Added second 555 IC bypass cap
    [555PWMTremolo-B.Cu.gbr, 555PWMTremolo-B.Mask.gbr, 555PWMTremolo-B.Paste.gbr, 555PWMTremolo-B.SilkS.gbr, 555PWMTremolo-Edge.Cuts.gbr, 555PWMTremolo-F.Cu.gbr, 555PWMTremolo-F.Mask.gbr, 555PWMTremolo-F.Paste.gbr]
2018-11-15 Reorganised docs folder
    [555PWMTremolo-B.Cu.gbr, 555PWMTremolo-B.Mask.gbr, 555PWMTremolo-B.Paste.gbr, 555PWMTremolo-B.SilkS.gbr, 555PWMTremolo-Edge.Cuts.gbr, 555PWMTremolo-F.Cu.gbr, 555PWMTremolo-F.Mask.gbr, 555PWMTremolo-F.Paste.gbr]
2018-11-16 Corrected DC Jack polarity
    [555PWMTremolo-B.Cu.gbr, 555PWMTremolo-B.Mask.gbr, 555PWMTremolo-B.Paste.gbr, 555PWMTremolo-B.SilkS.gbr, 555PWMTremolo-Edge.Cuts.gbr, 555PWMTremolo-F.Cu.gbr, 555PWMTremolo-F.Mask.gbr, 555PWMTremolo-F.Paste.gbr]
2018-11-25 added Atomizer AVR Design
    added Atomizer AVR Design
    [555PWMTremolo-B.Cu.gbr, 555PWMTremolo-B.Mask.gbr, 555PWMTremolo-B.Paste.gbr, 555PWMTremolo-B.SilkS.gbr, 555PWMTremolo-Edge.Cuts.gbr, 555PWMTremolo-F.Cu.gbr, 555PWMTremolo-F.Mask.gbr, 555PWMTremolo-F.Paste.gbr]
2018-11-26 Added Atomizer Design and Code
    [Atomizer.kicad_pcb, Atomizer.sch, Atomizer_3PDT.sch, Atomizer_Clock.sch]
2018-11-27 Added 3d Model
    [Atomizer.kicad_pcb, Atomizer_Clock.sch]
2018-11-28 Finished Atomizer RevB
    [Atomizer.kicad_pcb, Atomizer.sch, Atomizer_Clock.sch]
2018-11-29 Finished Atomizer RevA
    [555PWMTremolo-B.Cu.gbr, 555PWMTremolo-B.Mask.gbr, 555PWMTremolo-B.Paste.gbr, 555PWMTremolo-B.SilkS.gbr, 555PWMTremolo-F.Cu.gbr, 555PWMTremolo-F.Mask.gbr, 555PWMTremolo-F.Paste.gbr, 555PWMTremolo-F.SilkS.gbr]
2018-12-02 Updated BOM
    [Atomizer.kicad_pcb, Atomizer_Clock.sch]
2018-12-05 Added additional docs
    [AtomizerGrouped.csv, AtomizerGroupedBOM.csv, Project_Nov07_1150AM.xls]
2018-12-09 Updated Atomizer firmware
    Fixed pot range bugs
    [main.c]
2018-12-28 atomizer schematic graphics update
    [Atomizer.kicad_pcb]
2018-12-28 Updated BOM. Converted to Mouser list. Moved LED away from switch
    [Atomizer-B.Cu.gbr, Atomizer-B.Mask.gbr, Atomizer-B.Paste.gbr, Atomizer-B.SilkS.gbr, Atomizer-Edge.Cuts.gbr, Atomizer-F.Cu.gbr, Atomizer-F.Mask.gbr, Atomizer-F.Paste.gbr]
2019-01-14 fixed sweep mode bug
    During SWEEP mode (upperpot < 50) can cause MCU to reset. Fix is to set min value for upperpot when in this mode. Line 300 (TIMER1_COMPA_vect)
    [main.c]
2019-06-01 updated atomizer
    - changed input pulldown resistor from 22M to 1M
    - added output lpf filter (1uF, 100K)
    - updated docs
    [Atomizer.kicad_pcb, Atomizer.sch]
